edwwardk/EnviroMon/README.md

# EnviroMon
pic24fj64gb004 + lora based low power sensor platform
