edwwardk/EnviroMon/solder list.xlsx

Sheet: all
Designator | Quantity | Description | Name | Manufacturer | Part Number | Column1
BT1 | 1 | BATTERY HOLDER COIN 20MM SMD | BU2032SM-HD-G | Wurth Electronics
C1, C2, C3, C4, C15, C16 | 6 | Capacitor | Cap | Samsung | CL21B105KOFNNNE | 1u
C5, C6, C7 | 3 | Capacitor | Cap | Samsung | CL21A475KPFNNNE | 4.7u
C8, C9, C10, C11, C18, C23 | 6 | Capacitor | Cap | Samsung | CL21B104KACNNNC | 0.1u
C12, C14 | 2 | Capacitor | Cap | Samsung | CL21A225KAFNNNE | 2.2u
C13, C17 | 2 | Capacitor | Cap | Samsung | CL21A106KOQNNNE | 10u
C19 | 1 | Capacitor | Cap | Yageo | CC0805FRNPO9BN560 | 56p
C20, C21 | 2 | Capacitor | Cap | Samsung | CL21B102KBANNNC | 1n
C22 | 1 | Capacitor | Cap | Yageo | CC0805DRNPO9BN8R0 | 8p
D1, D2, D4 | 3 | Rectifier Diode Small Signal Schottky Si 0.8A 2-Pin USC T/R | Schottky Diode | Toshiba | CUS08F30,H3F
D3, D5 | 2 | CYAN LED | CYN
D6 | 1 | Green LED | GRN
D7 | 1 | Orange LED | ORN
D8, D9, D10, D11, D12, D13, D14, D15, D16, D17 | 10 | Red LED | RED
E1 | 1 | Generic Antenna | SMA connector
F1 | 1 | PTC Resettable Fuse 0.5A(hold) 1.1A(trip) 13.2VDC 100A 0.8W 0.1s 0.2Ohm SMD Solder Pad 1206 T/R Automotive | 0.5A Fuse | Littelfuse | RF1347-000
F2 | 1 | PTC Resettable Fuse 1.5A(hold) 3A(trip) 6VDC 100A 0.8W 0.3s 0.04Ohm SMD Solder Pad 1206 T/R | 1.5A Fuse | Littelfuse | RF1358-000
FB1 | 1 |  | Ferrite Bead | Wurth Electronics | 782763102
J1 | 1 | ICSP | ICSP
J2 | 1 | Input/Output | JST-PH
J3 | 1 | USB Type C Receptacle for USB 2.0, SMT Type Mid Mount, 1.6mm Offset | USB C Receptable | Global Connector Technology | USB4510-03-1-A
P1 | 1 | Header, 7-Pin | Header 7
P2 | 1 | Header, 9-Pin | Header 9
P3 | 1 | Header, 10-Pin | Header 10
P4 | 1 | Header, 5-Pin | Header 5
R1, R5, R7, R8, R9 | 5 | Resistor | Res1 |  |  | 1k
R2 | 1 | Resistor | Res1 |  |  | 10k
R3, R19, R20, R21, R22 | 5 | Resistor | Res1 |  |  | ???
R4, R18, R25 | 3 | Resistor | Res1 |  |  | 470
R6 | 1 | Resistor | Res1 |  |  | 3.3k
R10, R12, R23, R24 | 4 | Resistor | Res1 |  |  | 100k
R11 | 1 | Var MOV 4VAC/5.5VDC 30A 9.6V 0603 SMD Paper T/R | Varistor | Bourns | CG0603MLA-5.5ME
R13, R14 | 2 | Resistor | Res1 |  |  | 5.1k
R15 | 1 | Resistor | Res1 |  |  | 50
R16, R17 | 2 | Resistor | Res1 |  |  | 4.7k
R26, R27 | 2 | Resistor | Res1 |  |  | 1k
RT1 | 1 | Thermistor | Thermistor
S1 | 1 | SPDT Subminiature Toggle Switch, Right Angle Mounting, Vertical Actuation | SW-SPDT
S2, S3, S4 | 3 | Switch | SW-PB | ITT C&K | KT11B1SM34LFS
U1, U2, U7 | 3 | LDO Regulator Positive 2.8V 300mA 5-Pin SOT-25 | 2.8V Regulator
U3 | 1 | Battery Charge Controller Li-Ion/Li-Pol 1200mA 4.2V/4.35V/4.4V/4.5V 10-Pin MSOP Tube | LiPo Charge Controller | Microchip | MCP73837-FJI/UN
U4 | 1 | 16-bit MCU/DSC, 64 KB, 8192 Bytes, 32 MHz, 2 to 3.6V, TQFP-44, RoHS | Main Microcontroller | Microchip | PIC24FJ64GB004T-I/PT
U5 | 1 | V-Ref Precision 2.048V 20mA 6-Pin SOT-23 T/R | Precision Voltage Reference | Microchip | MCP1501T-20E/CHY
U6 | 1 | ESD Suppressor Diode TVS Bi-Dir 12V Automotive 3-Pin USM T/R | TVS Diode | Toshiba | DF3D18FU,LF
U8 | 1 | Rx Txrx Module Ism < 1GHZ SMD | RFM95 Transceiver | RF Solutions | RFM95W-915S2
U9 | 1 | EEPROM Serial-SPI 512K-bit 64K x 8 2.5V/3.3V/5V 8-Pin TSSOP-B T/R | 512kb EEPROM | Rohm | BR25G512FVT-3GE2
U10 | 1 | MC74HC541ADWG Octal Buffer & Line Driver; 3-State; 2 - 6 V; 20-Pin SOIC | Octal Buffer | ON Semiconductor | MC74HC541ADWG
U11 | 1 | Real Time Clock Serial 64byte Clock/Calendar/Alarm/Battery Backup Automotive 8-Pin MSOP Tube | RTC | Microchip | MCP79411-I/MS
W1 | 1 | 2 pin jumper | Jumper
Y1 | 1 | Crystal 0.032768MHz ±10ppm (Tol) 7pF Flexural 90000Ohm Automotive 2-Pin Ultra Mini-CSMD T/R | 32.768kHz | ECS International | ECS-.327-7-12-C-TR

Sheet: reflow
Designator | Quantity | Description | Name | Manufacturer | Part Number
C1, C2, C3, C4, C15, C16 | 6 | Capacitor | Cap | Samsung | CL21B105KOFNNNE
C5, C6, C7 | 3 | Capacitor | Cap | Samsung | CL21A475KPFNNNE
C8, C9, C10, C11, C18, C23 | 6 | Capacitor | Cap | Samsung | CL21B104KACNNNC
C12, C14 | 2 | Capacitor | Cap | Samsung | CL21A225KAFNNNE
C13, C17 | 2 | Capacitor | Cap | Samsung | CL21A106KOQNNNE
C19 | 1 | Capacitor | Cap | Yageo | CC0805FRNPO9BN560
C20, C21 | 2 | Capacitor | Cap | Samsung | CL21B102KBANNNC
C22 | 1 | Capacitor | Cap | Yageo | CC0805DRNPO9BN8R0
D1, D2, D4 | 3 | Rectifier Diode Small Signal Schottky Si 0.8A 2-Pin USC T/R | Schottky Diode | Toshiba | CUS08F30,H3F
D3, D5 | 2 | CYAN LED | CYN
D6 | 1 | Green LED | GRN
D7 | 1 | Orange LED | ORN
D8, D9, D10, D11, D12, D13, D14, D15, D16, D17 | 10 | Red LED | RED
F1 | 1 | PTC Resettable Fuse 0.5A(hold) 1.1A(trip) 13.2VDC 100A 0.8W 0.1s 0.2Ohm SMD Solder Pad 1206 T/R Automotive | 0.5A Fuse | Littelfuse | RF1347-000
F2 | 1 | PTC Resettable Fuse 1.5A(hold) 3A(trip) 6VDC 100A 0.8W 0.3s 0.04Ohm SMD Solder Pad 1206 T/R | 1.5A Fuse | Littelfuse | RF1358-000
FB1 | 1 |  | Ferrite Bead | Wurth Electronics | 782763102
J3 | 1 | USB Type C Receptacle for USB 2.0, SMT Type Mid Mount, 1.6mm Offset | USB C Receptable | Global Connector Technology | USB4510-03-1-A
R1, R5, R7, R8, R9 | 5 | Resistor | Res1
R2 | 1 | Resistor | Res1
R3, R19, R20, R21, R22 | 5 | Resistor | Res1
R4, R18, R25 | 3 | Resistor | Res1
R6 | 1 | Resistor | Res1
R10, R12, R23, R24 | 4 | Resistor | Res1
R11 | 1 | Var MOV 4VAC/5.5VDC 30A 9.6V 0603 SMD Paper T/R | Varistor | Bourns | CG0603MLA-5.5ME
R13, R14 | 2 | Resistor | Res1
R15 | 1 | Resistor | Res1
R16, R17 | 2 | Resistor | Res1
R26, R27 | 2 | Resistor | Res1
S2, S3, S4 | 3 | Switch | SW-PB | ITT C&K | KT11B1SM34LFS
U1, U2, U7 | 3 | LDO Regulator Positive 2.8V 300mA 5-Pin SOT-25 | 2.8V Regulator
U3 | 1 | Battery Charge Controller Li-Ion/Li-Pol 1200mA 4.2V/4.35V/4.4V/4.5V 10-Pin MSOP Tube | LiPo Charge Controller | Microchip | MCP73837-FJI/UN
U4 | 1 | 16-bit MCU/DSC, 64 KB, 8192 Bytes, 32 MHz, 2 to 3.6V, TQFP-44, RoHS | Main Microcontroller | Microchip | PIC24FJ64GB004T-I/PT
U5 | 1 | V-Ref Precision 2.048V 20mA 6-Pin SOT-23 T/R | Precision Voltage Reference | Microchip | MCP1501T-20E/CHY
U6 | 1 | ESD Suppressor Diode TVS Bi-Dir 12V Automotive 3-Pin USM T/R | TVS Diode | Toshiba | DF3D18FU,LF
U8 | 1 | Rx Txrx Module Ism < 1GHZ SMD | RFM95 Transceiver | RF Solutions | RFM95W-915S2
U9 | 1 | EEPROM Serial-SPI 512K-bit 64K x 8 2.5V/3.3V/5V 8-Pin TSSOP-B T/R | 512kb EEPROM | Rohm | BR25G512FVT-3GE2
U10 | 1 | MC74HC541ADWG Octal Buffer & Line Driver; 3-State; 2 - 6 V; 20-Pin SOIC | Octal Buffer | ON Semiconductor | MC74HC541ADWG
U11 | 1 | Real Time Clock Serial 64byte Clock/Calendar/Alarm/Battery Backup Automotive 8-Pin MSOP Tube | RTC | Microchip | MCP79411-I/MS
Y1 | 1 | Crystal 0.032768MHz ±10ppm (Tol) 7pF Flexural 90000Ohm Automotive 2-Pin Ultra Mini-CSMD T/R | 32.768kHz | ECS International | ECS-.327-7-12-C-TR

Sheet: hand solder
Designator | Quantity | Description | Name | Manufacturer | Part Number
BT1 | 1 | BATTERY HOLDER COIN 20MM SMD | BU2032SM-HD-G | Wurth Electronics | 782763102
E1 | 1 | Generic Antenna | SMA connector
J1 | 1 | ICSP | ICSP
J2 | 1 | Input/Output | JST-PH
J3 | 1 | USB Type C Receptacle for USB 2.0, SMT Type Mid Mount, 1.6mm Offset | USB C Receptable | Global Connector Technology | USB4510-03-1-A
P1 | 1 | Header, 7-Pin | Header 7
P2 | 1 | Header, 9-Pin | Header 9
P3 | 1 | Header, 10-Pin | Header 10
P4 | 1 | Header, 5-Pin | Header 5
RT1 | 1 | Thermistor | Thermistor
S1 | 1 | SPDT Subminiature Toggle Switch, Right Angle Mounting, Vertical Actuation | SW-SPDT
W1 | 1 | 2 pin jumper | Jumper

Sheet: unsure
Designator | Quantity | Description | Name | Manufacturer | Part Number
D1, D2, D4 | 3 | Rectifier Diode Small Signal Schottky Si 0.8A 2-Pin USC T/R | Schottky Diode | Toshiba | CUS08F30,H3F
F1 | 1 | PTC Resettable Fuse 0.5A(hold) 1.1A(trip) 13.2VDC 100A 0.8W 0.1s 0.2Ohm SMD Solder Pad 1206 T/R Automotive | 0.5A Fuse | Littelfuse | RF1347-000
F2 | 1 | PTC Resettable Fuse 1.5A(hold) 3A(trip) 6VDC 100A 0.8W 0.3s 0.04Ohm SMD Solder Pad 1206 T/R | 1.5A Fuse | Littelfuse | RF1358-000
FB1 | 1 |  | Ferrite Bead | Wurth Electronics | 782763102
R11 | 1 | Var MOV 4VAC/5.5VDC 30A 9.6V 0603 SMD Paper T/R | Varistor | Bourns | CG0603MLA-5.5ME
S2, S3, S4 | 3 | Switch | SW-PB | ITT C&K | KT11B1SM34LFS
U8 | 1 | Rx Txrx Module Ism < 1GHZ SMD | RFM95 Transceiver | RF Solutions | RFM95W-915S2
Y1 | 1 | Crystal 0.032768MHz ±10ppm (Tol) 7pF Flexural 90000Ohm Automotive 2-Pin Ultra Mini-CSMD T/R | 32.768kHz | ECS International | ECS-.327-7-12-C-TR
