edwwardk/EnviroMon/pinallocation.xlsx

Sheet: mcu
selected | # | description | side | schematic group
SDA1/RP9/RB9 | 1 | SDA1/RP9/PMD3/RCV/CN21/RB9 | W | i2c
RP22/RC6 | 2 | RP22/PMA1/CN18/RC6 | W | spi
RP23/RC7 | 3 | RP23/PMA0/CN17/RC7 | W | spi
RP24/RC8 | 4 | RP24/PMA5/CN20/RC8 | W | spi
RP25/RC9 | 5 | RP25/PMA6/CN19/RC9 | W | gpio
DISVREG | 6 | DISVREG | W | vss
VCAP/VDDCORE | 7 | VCAP/VDDCORE | W | vss
D+/RP10/RB10 | 8 | PGED2/D+/VPIO/RP10/CN16/RB10 | W | usb
D-/RP11/RB11 | 9 | PGEC2/D-/VMIO/RP11/CN15/RB11 | W | usb
VUSB | 10 | VUSB | W | vdd
AN11/RP13/RB13 | 11 | AN11/C1INC/RP13/REFO/PMRD/SESSEND/CN13/RB13 | W | gpio
RA10 | 12 | TMS/PMA10/RA10 | S | spi
RA7 | 13 | TCK/PMA7/RA7 | S | gpio
AN10/RP14/RB14 | 14 | AN10/C3INB/CVREF/VCPCON/VBUSON/RP14/CN12/RB14 | S | gpio
AN9/RP15/RB15 | 15 | AN9/C3INA/VBUSCHG/RP15/VBUSST/CN11/RB15 | S | gpio
AVSS | 16 | AVSS | S | vss
AVDD | 17 | AVDD | S | vdd
MCLR | 18 | MCLR | S | icsp
VREF+/RP5/RA0 | 19 | PGED3/AN0/C3INC/VREF+/ASDA1/RP5/PMD7/CTED1/VBUSVLD/VCMPST1/CN2/RA0 | S | adc
RP6/RA1 | 20 | PGEC3/AN1/C3IND/VREF-/ASCL1/RP6/PMD6/CTED2/SESSVLD/VCMPST2/CN3/RA1 | S | adc
PGED1/RP0/RB0 | 21 | PGED1/AN2/C2INB/DPH/RP0/PMD0/CN4/RB0 | S | icsp
PGEC1/RP1/RB1 | 22 | PGEC1/AN3/C2INA/DMH/RP1/PMD1/CN5/RB1 | S | icsp
AN4/RP2/RB2 | 23 | AN4/C1INB/DPLN/SDA2/RP2/PMD2/CN6/RB2 | E | gpio
AN5/RTCC/RP3/RB3 | 24 | AN5/C1INA/DMLN/RTCC/SCL2/RP3/PMWR/CN7/RB3 | E | gpio?
AN6/RP16/RC0 | 25 | AN6/RP16/CN8/RC0 | E | gpio
AN7/RP17/RC1 | 26 | AN7/RP17/CN9/RC1 | E | gpio
AN8/RP18/RC2 | 27 | AN8/RP18/PMA2/CN10/RC2 | E | gpio
VDD | 28 | VDD | E | vdd
VSS | 29 | VSS | E | vss
OSCI/CLKI/RA2 | 30 | OSCI/CLKI/C1IND/PMCS1/CN30/RA2 | E | osc
OSCO/CLKO/RA3 | 31 | OSCO/CLKO/CN29/RA3 | E | osc
RA8 | 32 | TDO/PMA8/RA8 | E | gpio
SOSCI/RP4/RB4 | 33 | SOSCI/C2IND/RP4/CN1/RB4 | E | osc
SOSCO/SCKLI/RA4 | 34 | SOSCO/SCLKI/T1CK/C2INC/CN0/RA4 | N | osc
RA9 | 35 | TDI/PMA9/RA9 | N | gpio
AN12/RP19/RC3 | 36 | AN12/RP19/PMBE/CN28/RC3 | N | gpio
RP20/RC4 | 37 | RP20/PMA4/CN25/RC4 | N | gpio
RP21/RC5 | 38 | RP21/PMA3/CN26/RC5 | N | gpio
VSS | 39 | VSS | N | vss
VDD | 40 | VDD | N | vdd
RB5 | 41 | CN27/USBID/RB5 | N | gpio
VBUS | 42 | VBUS | N | usb
INT0/RP7/RB7 | 43 | RP7/PMD5/INT0/CN23/RB7 | N | interrupts
SCL1/RP8/RB8 | 44 | USBOEN/SCL1/RP8/PMD4/CN22/RB8 | N | i2c

Sheet: power
part | req voltage [V] | supply source
mcu | 2.2 - 3.6 | vreg
vref | 2.25 - 5.5 | vreg
lipo charge | < 6 basically | vbus
eeprom | 1.8 - 5.5 | vreg
octal buffer | 2.0 - 6.0 | vdbg
reg1 (primary) | 1.5 - 5.5 | vin
reg2 (debug) | 1.5 - 5.5 | vin | separate reg for debug
rfm95 | 1.8 - 3.7 | vrf
reg3 (rfm95) | 1.5 - 5.5 | vin | separate reg for noise isolation for rfm95
rtc | 1.8 - 5.5 vcc | vreg
 | 1.3 - 5.5 vbat | vcell
sources
vreg
vdbg | put on enable pin - used for debug
vrf | put on enable pin - used for rfm95
vbus
vbat | fuse between vbatin and vbat
vin
vcell | button cell battery (prob cr2032)

Sheet: leds
name | source | color
reg1 out |  | green
reg3 out |  | green
vbat |  | green
i2c clock |  | red
spi clock |  | red
mem clock |  | red
int0 |  | green
int1 |  | green
heartbeat | rtcc | red
usb connection | vbus | cyan
debug enable | vdbg | red
charging |  | orange
chg power |  | cyan
chg complete |  | green

Sheet: headers
rfm95 extra (5) | spi bus (9) | i2c bus (7) | mcu pins (10)
dio1 | vreg | vreg | vbus
dio2 | gnd | gnd | gnd
dio3 | sclk | sda | pin 14
dio4 | gnd | gnd | pin 15
dio5 | mosi | scl | pin 23
 | gnd | gnd | pin 25
 | miso | vreg | pin 26
 | gnd |  | pin 27
 | vreg |  | gnd
 |  |  | vbus
