edwwardk/EnviroMon/altium/rev1-env/sch-rev-env.pdf

Main Power LiPo Charging | Pin Headers

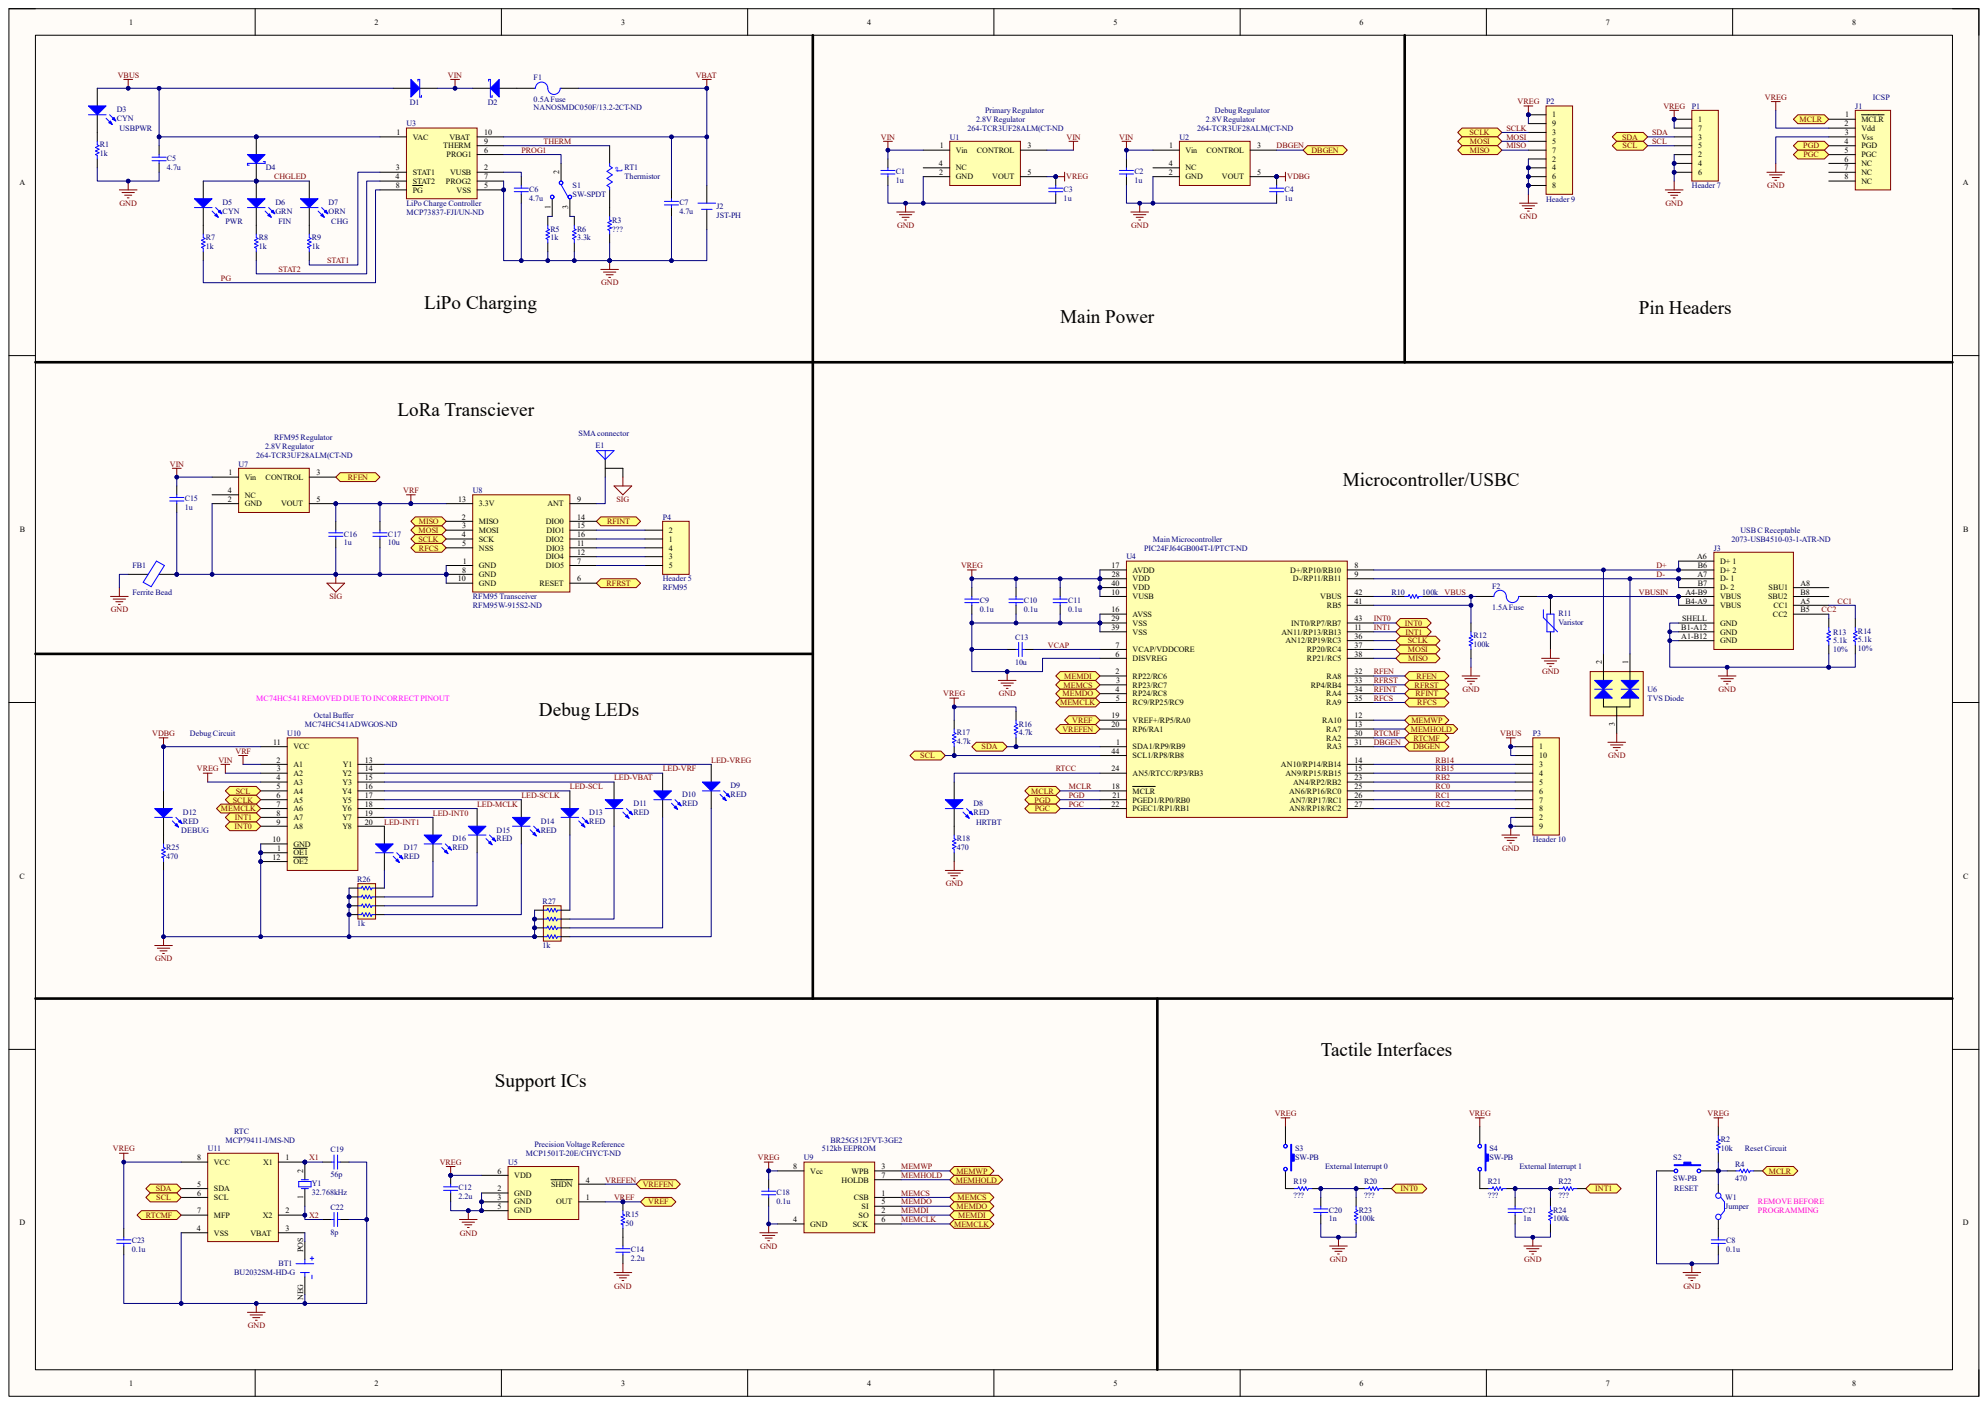
[picture p1: page 1]

MC74HC541 REMOVED DUE TO INCORRECT PINOUT
