edwwardk/EnviroMon/altium/batmon-env/batmon-sch-env.pdf

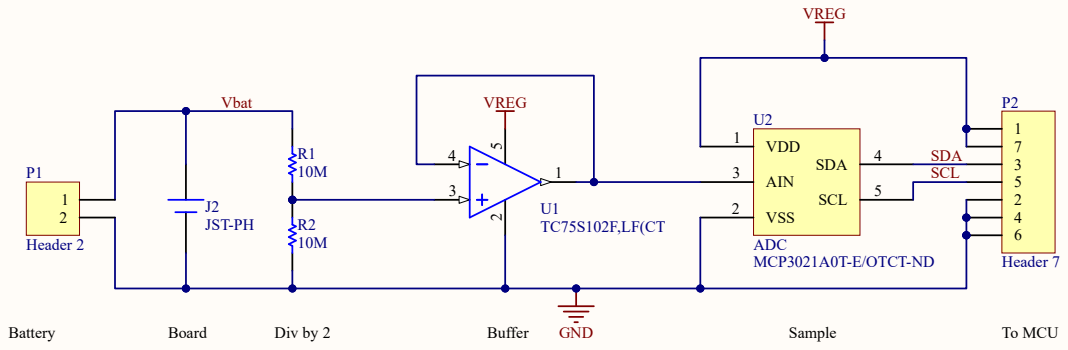
[picture p2: page 1]
Title; Size; Number; Revision; Date:; Sheet of; File:; C:\Users\..\batsch-env.SchDoc; Drawn By:; SDA SCL; Header 7; VREG; J2 JST-PH; GND; Vbat; Div by 2; Buffer; Sample; To MCU; VDD 1; VSS 2; AIN 3; SCL; SDA; MCP3021A0T-E/OTCT-ND; ADC; Battery; Board; Header 2
