edwwardk/EnviroMon/altium/rev1-env/pcb-rev1-env.pdf

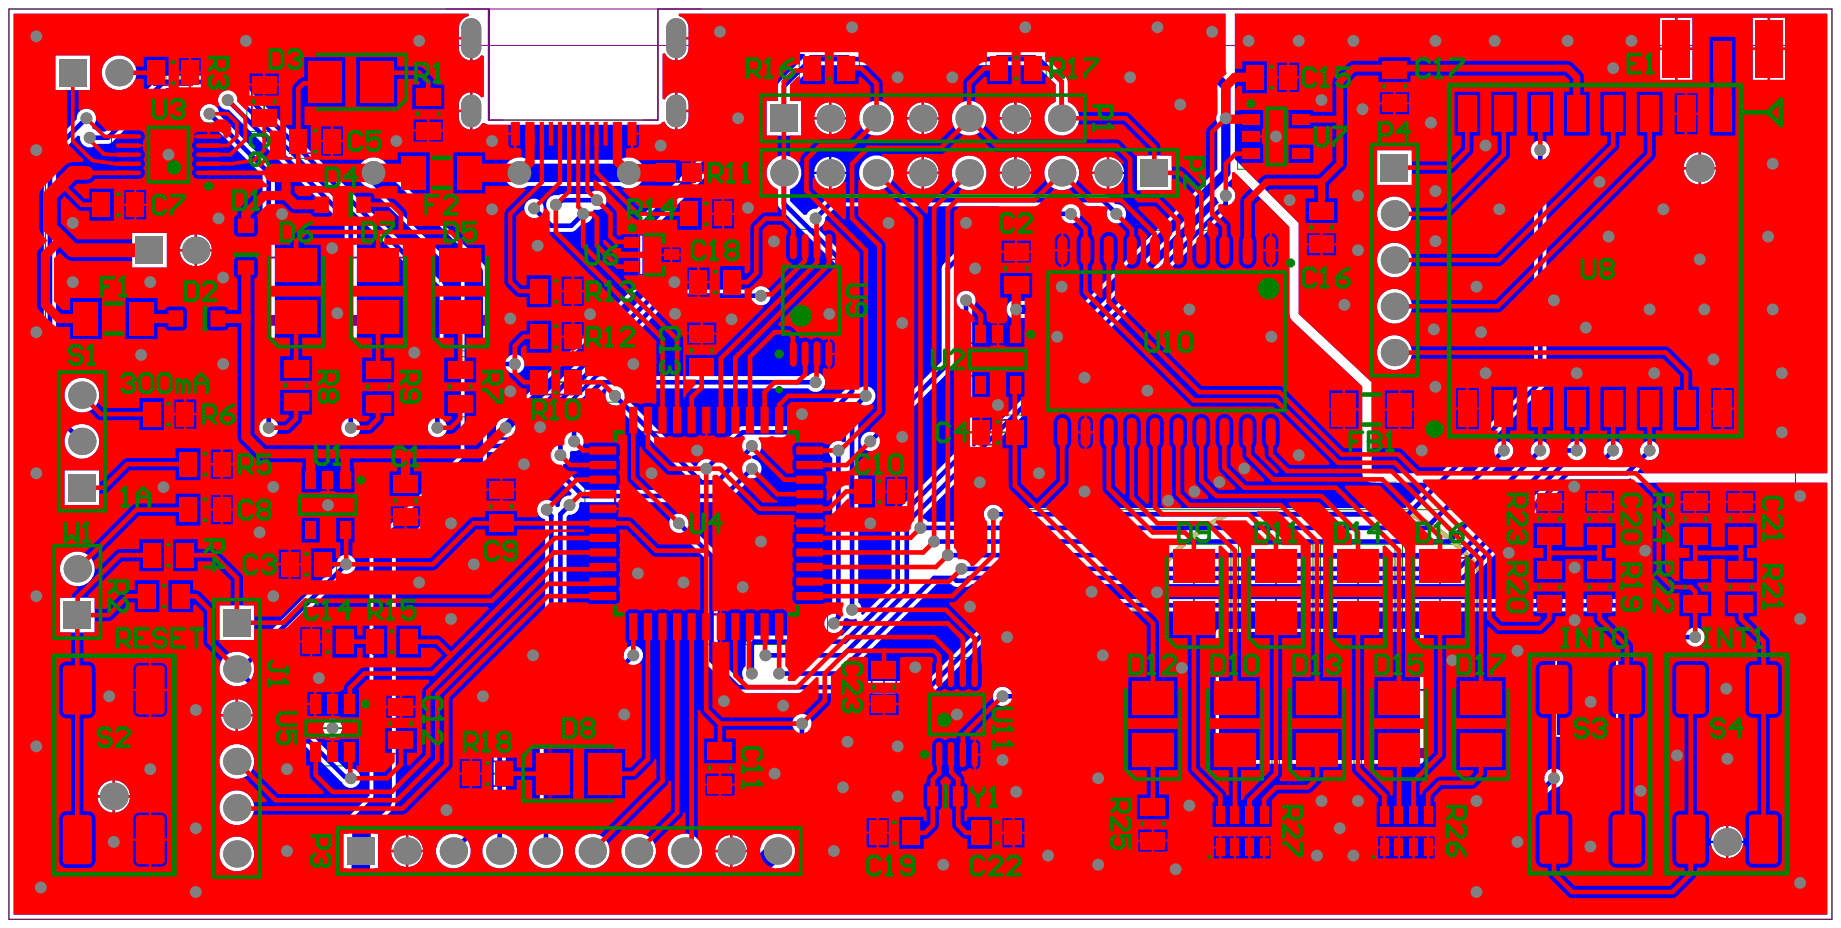
[picture p3: page 1]
