edwwardk/EnviroMon/(list of files, drawings)

Other design files:
altium/batmon-env/batmon-env.PrjPcb
altium/batmon-env/batpcb-env.PcbDoc
altium/batmon-env/batsch-env.SchDoc
altium/main-env/main-env.PrjPcb
altium/main-env/pcbmain-env.PcbDoc
altium/main-env/schmain-env.SchDoc
altium/rev1-env/blockd2-rev1-env.SchDoc
altium/rev1-env/blockd-rev1-env.SchDoc
altium/rev1-env/pcb-rev1-env.PcbDoc
altium/rev1-env/rev1-env.PrjPcb
altium/rev1-env/sch-rev1-env.SchDoc
altium/rev1-env/stated-rev1-env.SchDoc
