edwwardk/EnviroMon/code/sys-isr-env.h

/* 
 * sys-isr-env.h
 * written by edward kneller
 * 
 * handles all interrupt services routines
 * centralized for easy access
 * 
 * 
 * ~~~ defines ~~~
 * 
 * 
 * ~~~ global variables ~~~
 * 
 * 
 * ~~~ functions ~~~
 * void _INT0Interrupt();
 * - isr for external INT0
 * 
 * void _INT1Interrupt();
 * - isr for external INT1
 * 
 * void _RTCCInterrupt();
 * - isr for RTCC alarm
 * 
 * void _USB1Interrupt();
 * - isr for USB interrupts
 */

// include catch clause
#ifndef SYS_ISR_ENV_H
#define SYS_ISR_ENV_H

// ensure sys inclusions
#include <xc.h>
#include "sys-cfg-env.h"

// int0 isr
void __attribute__((__interrupt__, no_auto_psv)) _INT0Interrupt(void) {
    _INT0IF = 0; // reset int0 flag
}

// int1 isr
void __attribute__((__interrupt__, no_auto_psv)) _INT1Interrupt(void) {
    _INT1IF = 0; // reset int1 flag
    
    // switch run mode
    if (run_mode != manual_mode) {
        // set manual mode if not in manual
        run_mode = manual_mode; // set manual mode
        _RA3 = 1; // turn on LED for manual mode
        _RTCIE = 0; // disable rtcc interrupt
        
    } else {
        // set auto mode if current in manual
        run_mode = auto_mode; // set auto mode if current in manual
        _RA3 = 0; // turn off led
        _RTCIE = 1; // enable rtcc interrupt
    }
}

// rtcc isr
void __attribute__((__interrupt__, no_auto_psv)) _RTCCInterrupt(void) {
    _RTCIF = 0; // reset rtcc flag
}
#endif
