edwwardk/EnviroMon/code/i2c-env.h

/* 
 * i2ccfg.h
 * written by edward kneller
 * 
 * configures pps, control regs, initial states
 * includes xc.h
 * 
 */

// include catch clause
#ifndef I2C_ENV_H
#define I2C_ENV_H

// ensure sys inclusions
#include <xc.h>
#include "sys-cfg-env.h"

// constant defs
#define ACK 0
#define NACK 1

// global variables


// func decs
void i2c_init();

void i2c_start();
void i2c_stop();
void i2c_restart();

void i2c_tx_byte(uint8_t);
uint8_t i2c_rx_byte(uint8_t);

// initialize i2c module
void i2c_init() {
    _I2C1MD = 0; // enable i2c1 power
    I2C1CONbits.I2CEN = 1; // disable i2c1 module
    
    I2C1BRG = 39; // fscl = ~100kHz
    I2C1STATbits.ACKSTAT = 1; // force ackstat high
    
    //I2C1CONbits.I2CEN = 1; // enable i2c1 module
}

// send byte
void i2c_tx_byte(uint8_t buf) {
    I2C1TRN = buf; // write byte to buffer
    while (I2C1STATbits.TBF); // wait for write
    while (I2C1STATbits.TRSTAT); // wait for transmit
}

// receive byte
uint8_t i2c_rx_byte(uint8_t ack) {
    I2C1CONbits.RCEN = 1; // enable receive mode
    while (!I2C1STATbits.RBF); // wait for read
    I2C1CONbits.ACKDT = ack; // to ack? or not to ack?
    I2C1CONbits.ACKEN = 1; // send ack sequence
    while (I2C1CONbits.ACKEN); // wait for ack
    return I2C1RCV;
}

// send start bit
void i2c_start() {
    I2C1CONbits.SEN = 1; // set start bit
    while (I2C1CONbits.SEN); // wait for start bit clear
}

// send stop bit
void i2c_stop() {
    I2C1CONbits.PEN = 1; // set stop bit
    while (I2C1CONbits.PEN); // wait for stop bit clear
}

// send restart bit
void i2c_restart() {
    I2C1CONbits.RSEN = 1; // set restart bit
    while (I2C1CONbits.RSEN); // wait for restart bit clear
}
#endif
