edwwardk/EnviroMon/code/template.h

/* 
 * template.h
 * written by edward kneller
 * 
 * template description
 * 
 * 
 * ~~~ defines ~~~
 * 
 * 
 * ~~~ global variables ~~~
 * 
 * 
 * ~~~ functions ~~~
 */

// include catch clause
#ifndef TEMPLATE_ENV_H
#define TEMPLATE_ENV_H

// ensure sys inclusions
#include <xc.h>
#include "sys-cfg-env.h"

// constant defs


// global variables


// func decs


#endif
