edwwardk/EnviroMon/(commit log)

2022-01-15 altium-reinit, battery cct mostly complete
    [EnviroMon-p1.SchDoc, EnviroMon.PcbDoc, EnviroMon.PcbLib, EnviroMon.PrjPcb, EnviroMon.SchLib, capstone-rev1-1.SchDoc, capstone-rev1.PrjPcb, capstone.PcbLib]
2022-01-17 regulator, diodes, input caps
    footprint/symbol for regulator, symbol for diode, input caps added in
    [EnviroMon-p1.SchDoc, EnviroMon.PcbLib, EnviroMon.SchLib]
2022-01-20 further power cct revision; mcu, usbc footprints open
    [EnviroMon-p1.SchDoc, EnviroMon-p2.SchDoc, EnviroMon.PrjPcb, EnviroMon.SchLib]
2022-01-23 added more footprints, refined ic paths, pins
    [EnviroMon-p1.SchDoc, EnviroMon-p2.SchDoc, EnviroMon.SchLib]
2022-01-25 01.24.22
    pin allocation table file, major ics mostly implemented
    [EnviroMon-p1.SchDoc, EnviroMon.PrjPcb, EnviroMon.SchLib, pinallocation.xlsx]
2022-01-28 01.28.22
    updated mcu symbol w/ optimizations, cleaned up sch overall, added switches, secondary regulator, other misc too tired to remember glhf
    [EnviroMon-p1.SchDoc, EnviroMon-p2.SchDoc, EnviroMon.PcbLib, EnviroMon.PrjPcb, EnviroMon.SchLib, pinallocation.xlsx]
2022-01-30 01.29.22
    rearranged sch, made vref symbol, added some LEDs, more LoRa symbol, updated pin allocation to include power sourcing/voltage reqs
    [EnviroMon-p1.SchDoc, EnviroMon.SchLib, pinallocation.xlsx]
2022-02-04 02.03.22
    sch home stretch
    up next: checking pin proximity, mcu pin compatibility
    [EnviroMon-p1.SchDoc, EnviroMon.PcbLib, EnviroMon.PrjPcb, EnviroMon.SchLib, pinallocation.xlsx]
2022-02-05 02.04.22
    up next: usb line protection, then pcb time!
    [EnviroMon-p1.SchDoc, EnviroMon.PrjPcb, EnviroMon.SchLib, pinallocation.xlsx]
2022-02-06 02.05.22
    most footprints finished, lots of parts placed on board
    [EnviroMon-p1.SchDoc, EnviroMon.PcbDoc, EnviroMon.PcbLib, EnviroMon.PrjPcb, EnviroMon.SchLib, pinallocation.xlsx]
2022-02-07 02.06.22
    left half of pcb routed, middle somewhat routed, all parts placed in mostly final positions (obviously will tweak as needed)
    [EnviroMon-p1.SchDoc, EnviroMon.PcbDoc, EnviroMon.PcbLib, EnviroMon.PrjPcb, EnviroMon.SchLib]
2022-02-07 02.07.22 - part 1
    made space to allow for simplicity when tweezing, changed plcc2 to have notch instead of +
    [EnviroMon-p1.SchDoc, EnviroMon.PcbDoc, EnviroMon.PcbLib, EnviroMon.PrjPcb, EnviroMon.SchLib]
2022-02-09 02.08.22
    basically done unless more changes have to be made; everything routed, ground planes poured, coin cell battery holder added
    [EnviroMon-p1.SchDoc, EnviroMon.PcbDoc, EnviroMon.PcbLib, EnviroMon.SchLib]
2022-02-10 02.09.22
    added footprints for 0 ohms on interrupt debouncers, cleaned up ground planes; mitigating "antenna" traces mostly, changed res values for LEDs
    [EnviroMon-p1.SchDoc, EnviroMon.PcbDoc, EnviroMon.PrjPcb]
2022-02-13 02.12.22
    pcb ordered version, init code project
    [EnviroMon-p1.SchDoc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]
2022-02-15 02.15.22
    made some header files, final version of pcb until further notice
    [EnviroMon.PcbDoc, EnviroMon.SchDoc, EnviroMon.SchLib]
2022-02-18 02.17.22
    updated supplier links with final parts, changed ifndef in pincfg
    [EnviroMon.SchDoc, EnviroMon.SchLib]
2022-02-21 no idea tbh
    [EnviroMon.PrjPcb]
2022-02-26 progress report vers
    added block diagram, cleaned up sch, idk what else
    [EnviroMon.PcbDoc, EnviroMon.PrjPcb, EnviroMon.SchDoc, EnviroMon.SchLib, enviromon-blockdiagram.SchDoc]
2022-03-03 bunch of renames, init batom proj
    [EnviroMon.PcbDoc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]
2022-03-03 reversion attempt 1 to report vers
    [batsch-env.SchDoc, main-env.PrjPcb]
2022-03-03 reversion attempt 2 to report vers
    [main-env.PrjPcb]
2022-03-03 buncha renames
    [batmon-env.PrjPcb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]
2022-03-03 finished batmon sch first rev
    [batmon-env.PrjPcb, batsch-env.SchDoc, pcbmain-env.PcbDoc]
2022-03-03 finished batmon schematic/pcb
    [batmon-env.PrjPcb, batpcb-env.PcbDoc, batsch-env.SchDoc, main-env.PrjPcb]
2022-03-03 battery monitor production version
    [batmon-env.PrjPcb, batpcb-env.PcbDoc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]
2022-03-03 init many cfg files
    [batmon-env.PrjPcb]
2022-03-05 file struc, init headers, cfg int/pmd
    modified file structure slightly, mostly name changes
    initialized header files for usb and eeprom
    implemented init functions for external interrupts and pmd, unsure of CMPMD and UPWMMD bits
2022-03-07 solder list
    made solder list
    some minor changes in code and altium files, nothing major
    [solder list.xlsx]
2022-03-09 export sch pdf, work on more code
    code changes:
    made debug header
    developed mem header
    changed format of headers slightly
    [main-env.PrjPcb, schmain-env.SchDoc, solder list.xlsx]
2022-03-13 further restructured files, split alitums
    copied altium files for rev1 to allow for modifications for new rev on main files
    [blockd-rev1-env.SchDoc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]
2022-03-13 adc attempt
    adc does not currently work but will get there eventually
2022-03-13 adc works, temp sens does not
    not sure if its the sensor thats broken or not? voltage has been tested and is reading correctly but getting too high of a voltage from sensor.. not sure yet what problem is, will check at school
    [adc-env.h, debug-env.h, i2c-env.h, intcfg-env.h, isr-env.h, main.c, mem-env.h, rtcc-env.h]
2022-03-15 more minor changes
    restructuring/renaming, init project for testing usb
    [main-env.PrjPcb, pcb-rev1-env.PcbDoc, sch-rev1-env.SchDoc]
2022-03-17 started main program flow
    started flow for main program routine, started spi cfg
    [batmon-env.PrjPcb, batsch-env.SchDoc]
2022-03-17 started i2cadc code
2022-03-19 started rtc, kinda finished adc maybe idk
2022-03-19 lora nope, batmon maybe?, snake-case now
2022-03-24 init arduino project for rx side
2022-03-25 make some changes to 'rev2' sch and pcb
    [pcbmain-env.PcbDoc, schmain-env.SchDoc]
2022-03-30 lora sends msg, arduino init
2022-03-30 attempt fix of arduino at school
    [main.c, main.cpp]
2022-03-31 cleanup, finalizing
    cleaned up arduino code
    lora sends addressed messages now
    made file for sample handling routines
2022-03-31 sensors work, mqtt works, trying rtcc
2022-04-05 func with WDT, power saves possible
    [pcb-rev1-env.PcbDoc]
2022-04-07 started flowchart and state diagram(s)
    [rev1-env.PrjPcb, stated-rev1-env.SchDoc]
2022-04-08 messsed around with new rev
    [pcbmain-env.PcbDoc, schmain-env.SchDoc]
2022-04-11 updated blockd, flowcharts, etc
    [blockd2-rev1-env.SchDoc, rev1-env.PrjPcb, sch-rev1-env.SchDoc, stated-rev1-env.SchDoc]
2022-04-15 idk what to call this
    [blockd2-rev1-env.SchDoc, rev1-env.PrjPcb, sch-rev1-env.SchDoc]
2022-04-19 include values in bom
    [main-env.PrjPcb, rev1-env.PrjPcb]
2022-04-28 modified arduino receiver code
2023-05-01 tried to fix but did not
    [main.cpp]
